CR-Nova/RCJ-soccer-CR_Nova/WhatsApp Image 2025-05-07 at 9.48.19 AM.jpeg

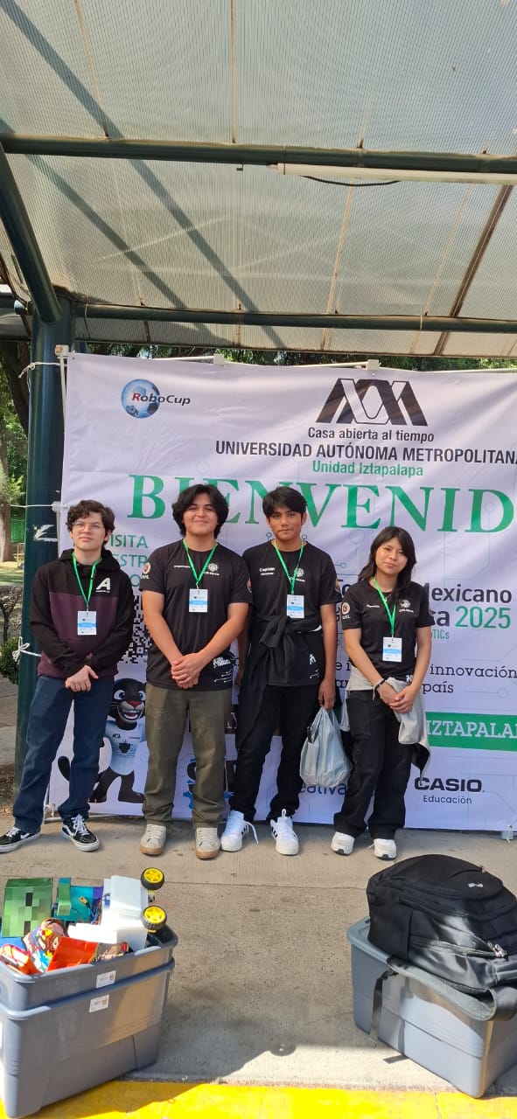
WhatsApp Image 2025-05-07 at 9.48.19 AM.jpeg
