CR-Nova/RCJ-soccer-CR_Nova/this desing was created.pdf

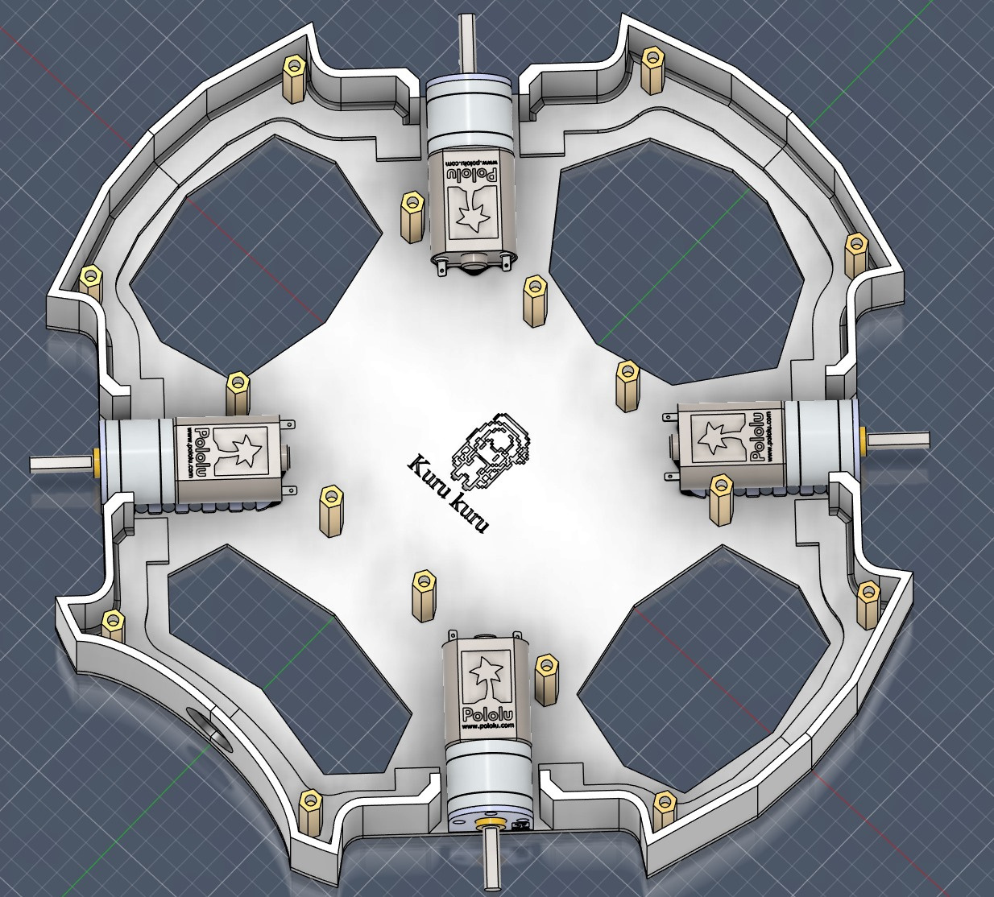
[picture p2: figure]

this design was created
so that the walls can be
easily uncoupled and
the robot is modular.

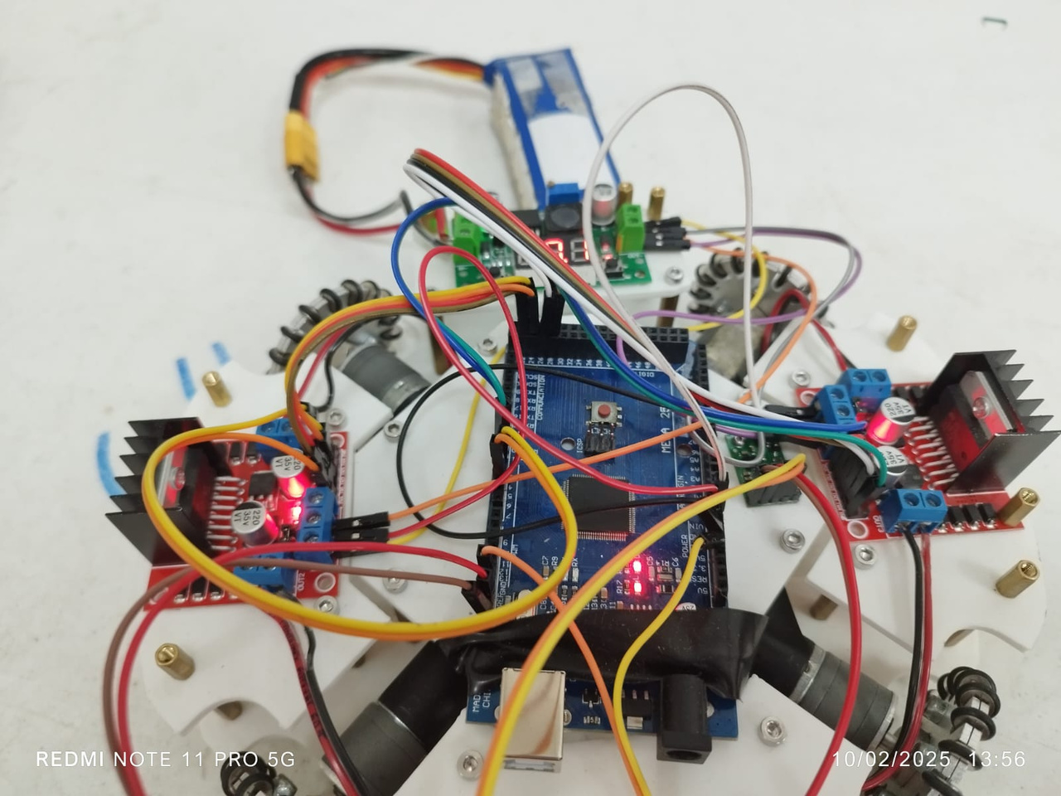
[picture p3: figure]

These were the
connections the robot
had before having the
pcb's.

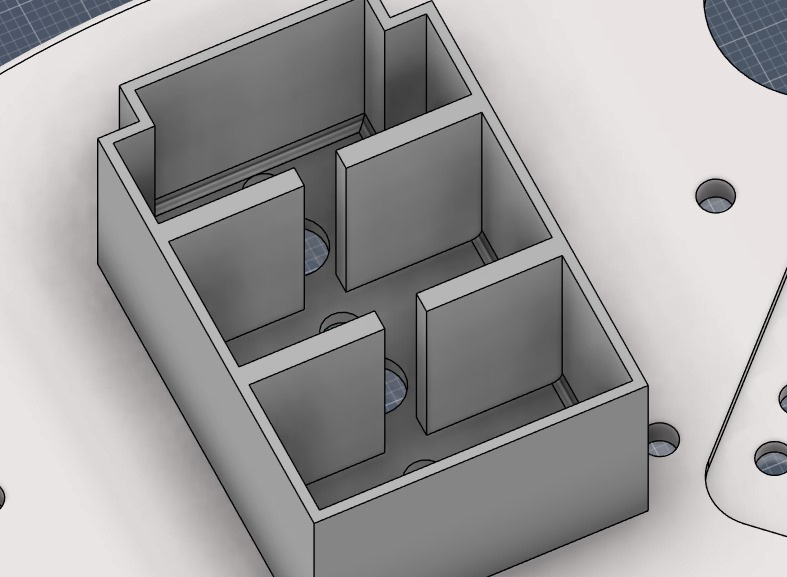
[picture p4: figure]

This was the first
design to use ldr
without a pcb.

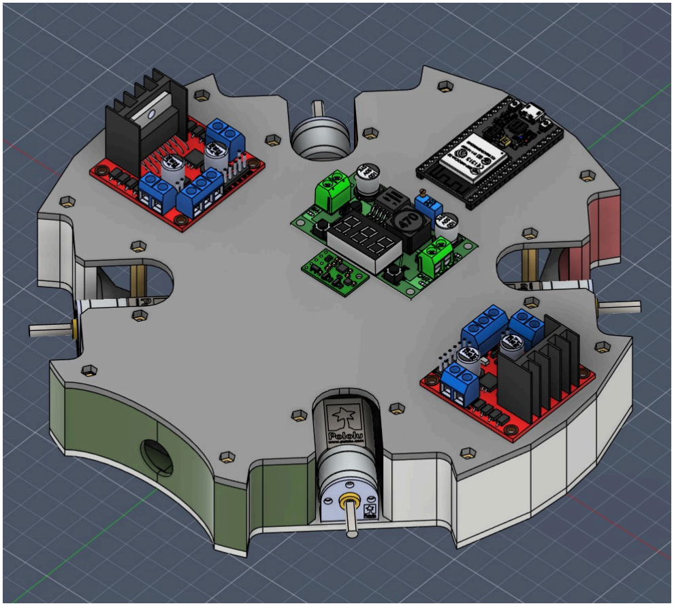
[picture p5: figure]

This is the design
contemplating that we
would use pcbs and we
had the idea of
implementing a kicker
but for economic
reasons we could not
implement it.

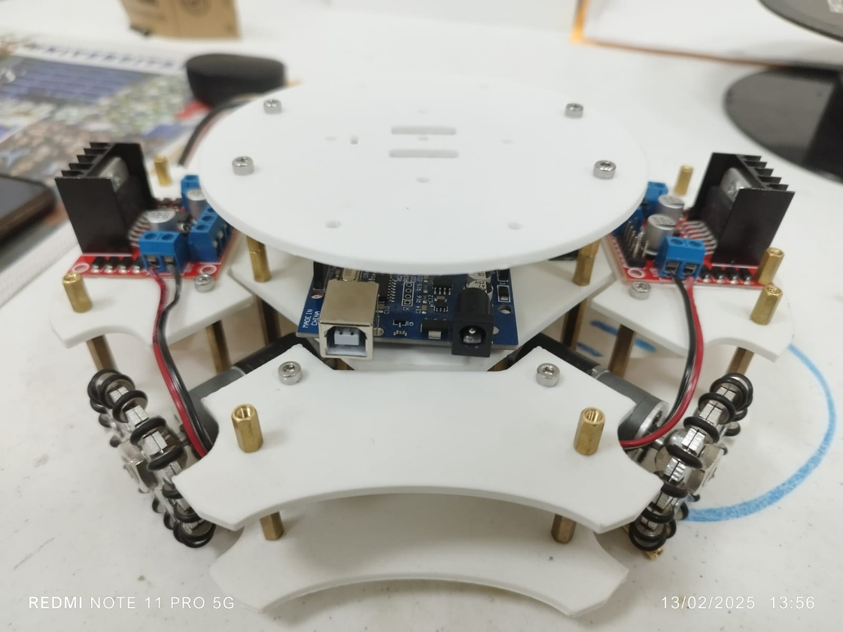
[picture p6: figure]

here the chassis had
already been printed
and the components
had been ordered

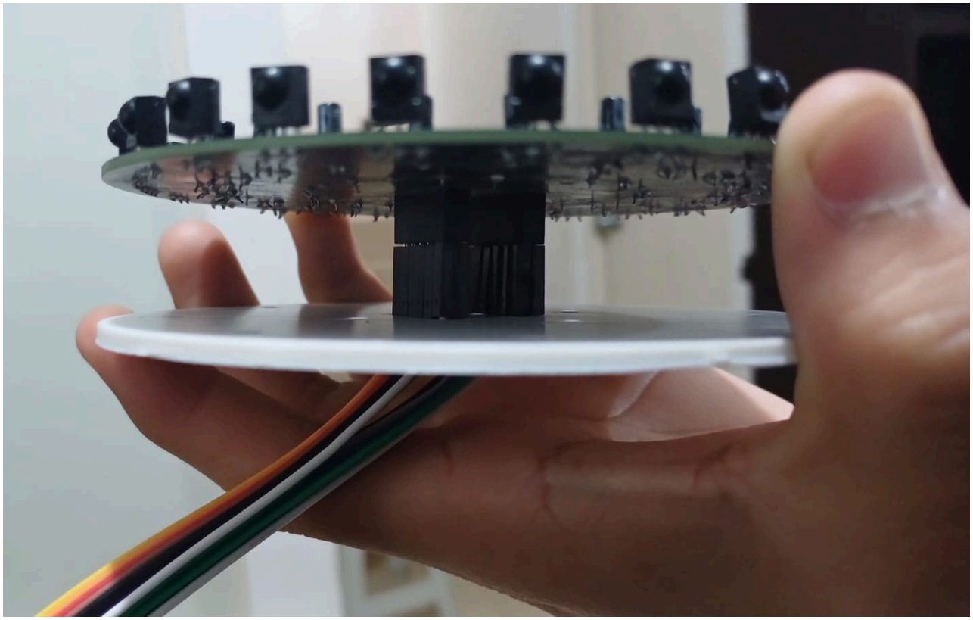
[picture p7: figure]

When we had the
plates ready to go we
started testing to see
how they would work.

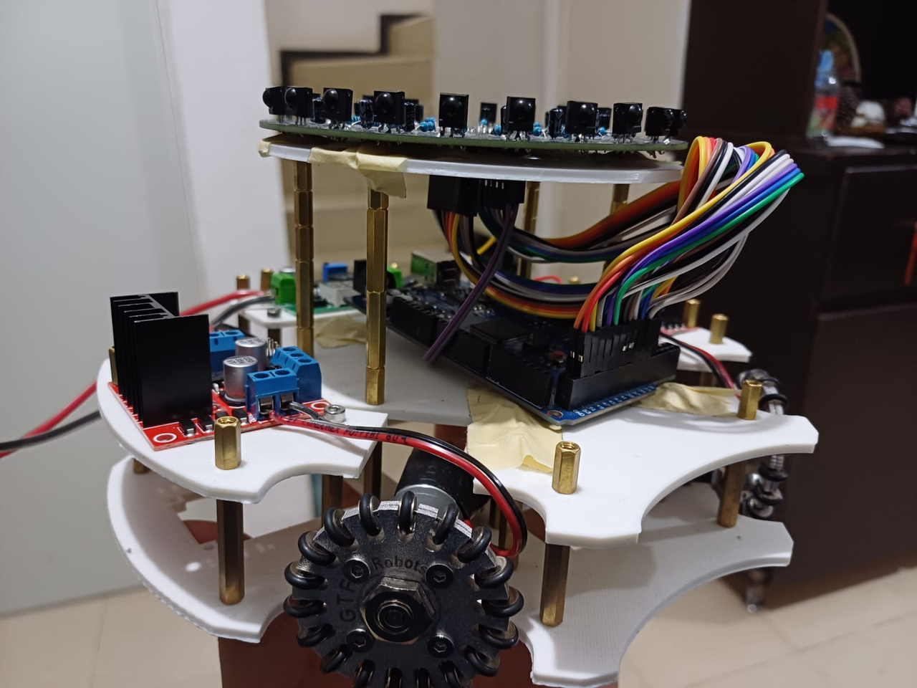
[picture p8: figure]

We arranged all the
parts of the robot and
the ir board was already
working.

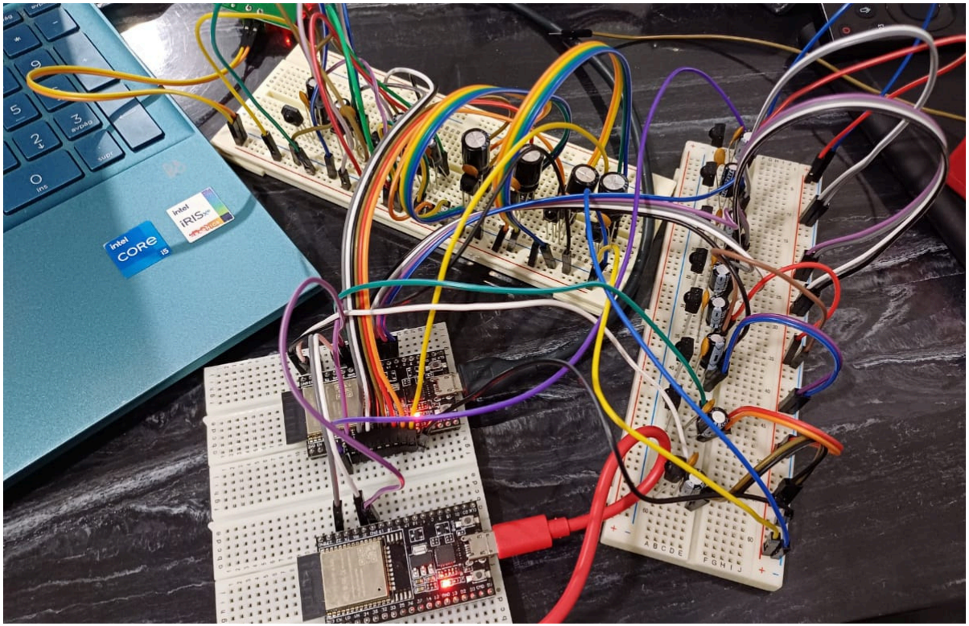
[picture p9: figure]

We made the schematic to test the operation of the second board, when it worked we tested the serial connection and ordered the board.

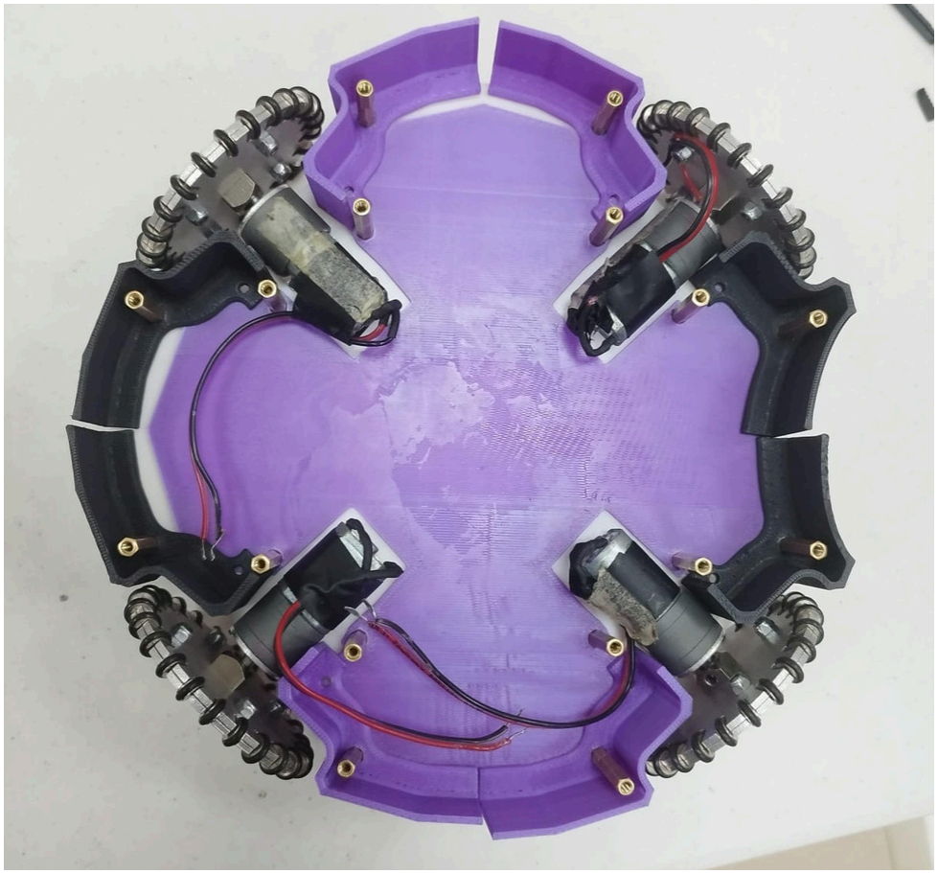
[picture p10: figure]

We made 3d printed
plates to test sizes
and shapes.

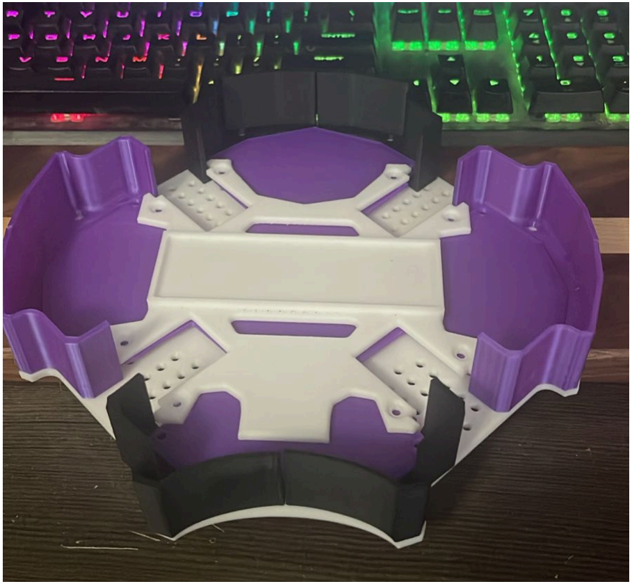
[picture p11: figure]

This is the final 3d
print design

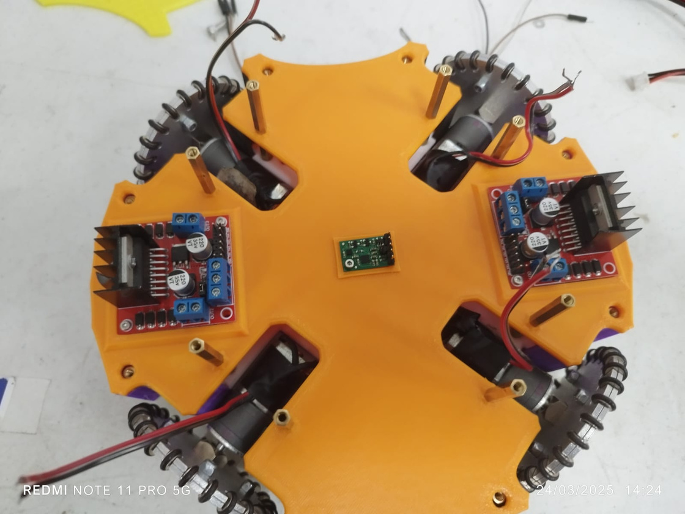
[picture p12: figure]

This is the second part
of the design with the
following components

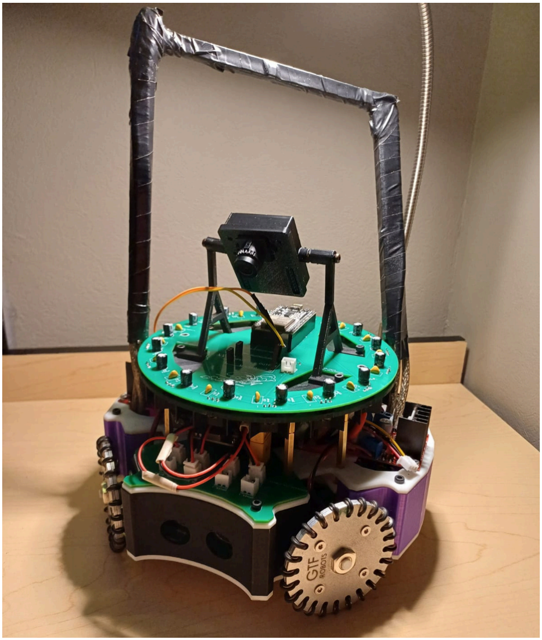
[picture p13: figure]

This is the final design
with the pcb and the open
mv
