CR-Nova/RCJ-soccer-CR_Nova/PCBs_PDFs/Schematic_PCB_CONTROLLER_2025-05-07.pdf

CLK 38 D0 37 D1 36 IO15 35 IO2 34 IO0 33 IO4 32 IO16 31 IO17 30 IO5 29 IO18 28 IO19 27 GND 26 IO21 25 RX 24 TX 23 IO22 22 IO23 21 GND 20

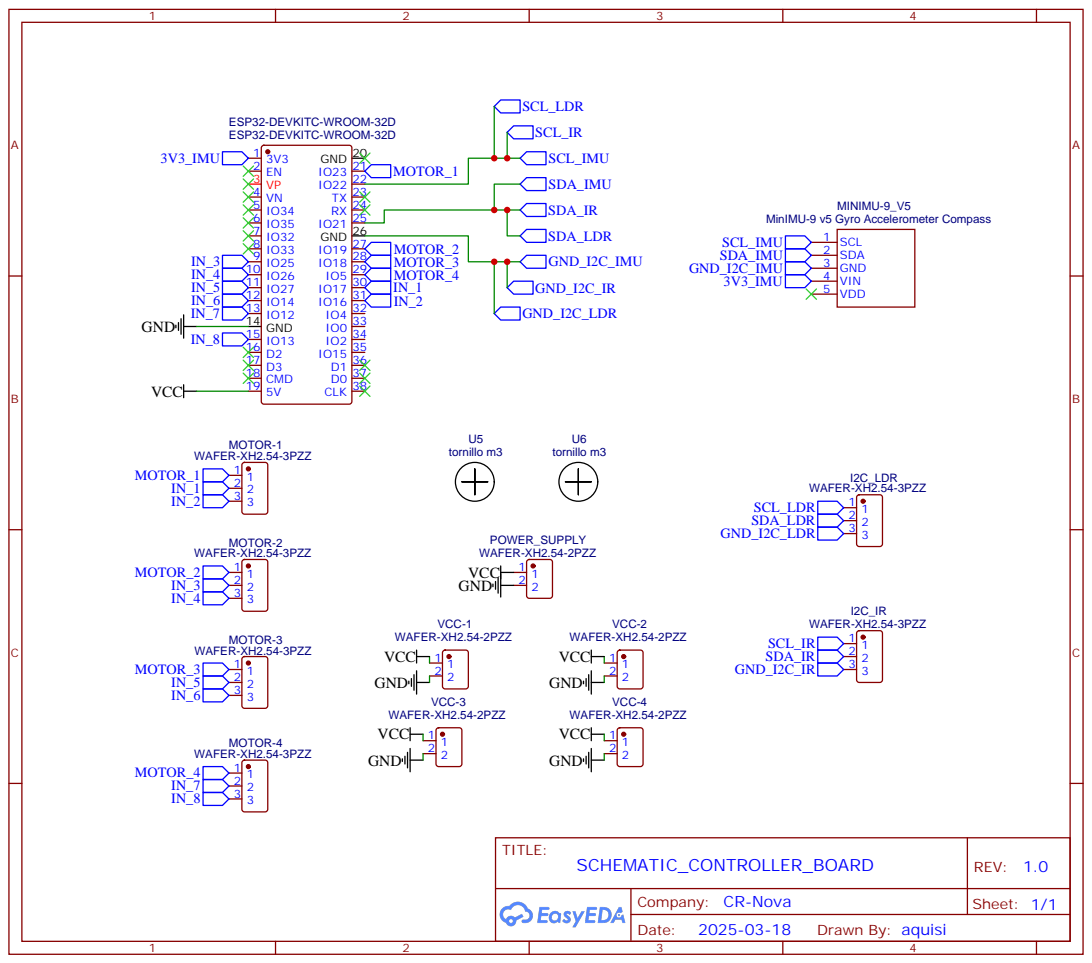
[picture p14: page 1]
