CR-Nova/RCJ-soccer-CR_Nova/PCBs_PDFs/Schematic_PCB_POWER_2025-05-07.pdf

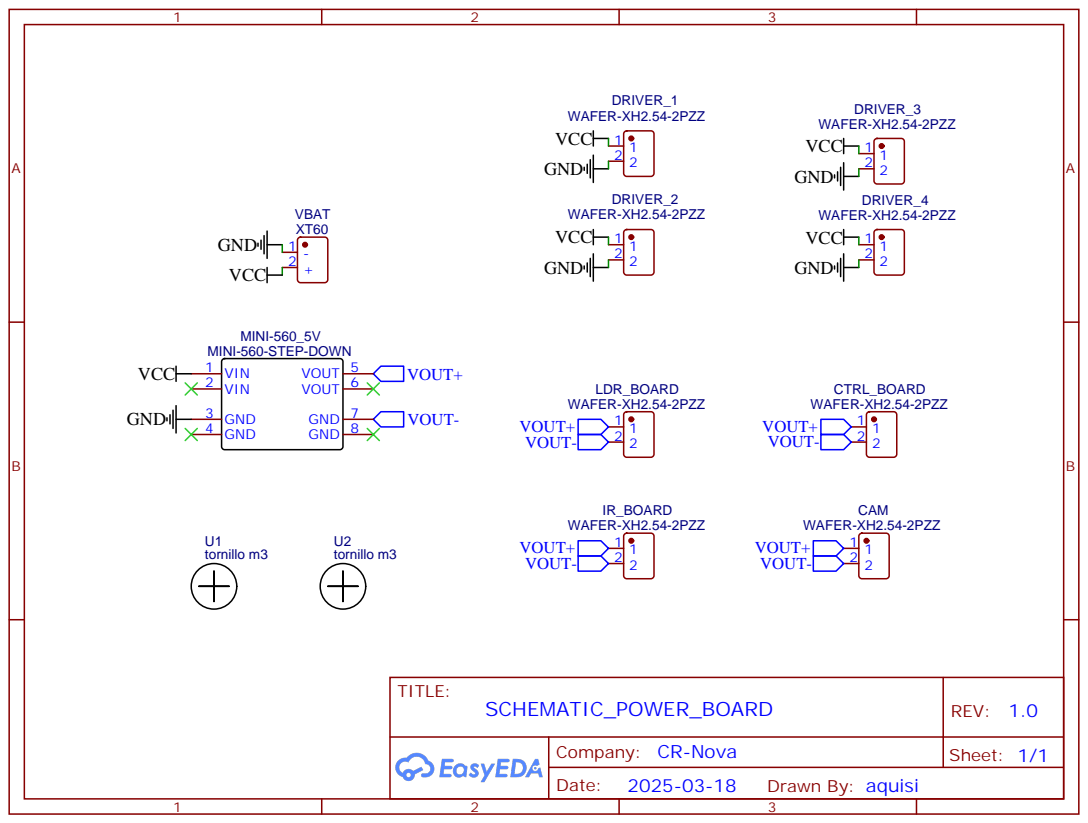
[picture p15: page 1]
