CR-Nova/RCJ-soccer-CR_Nova/PCBs_PDFs/PCB_CONTROLLER_2025-05-07.pdf

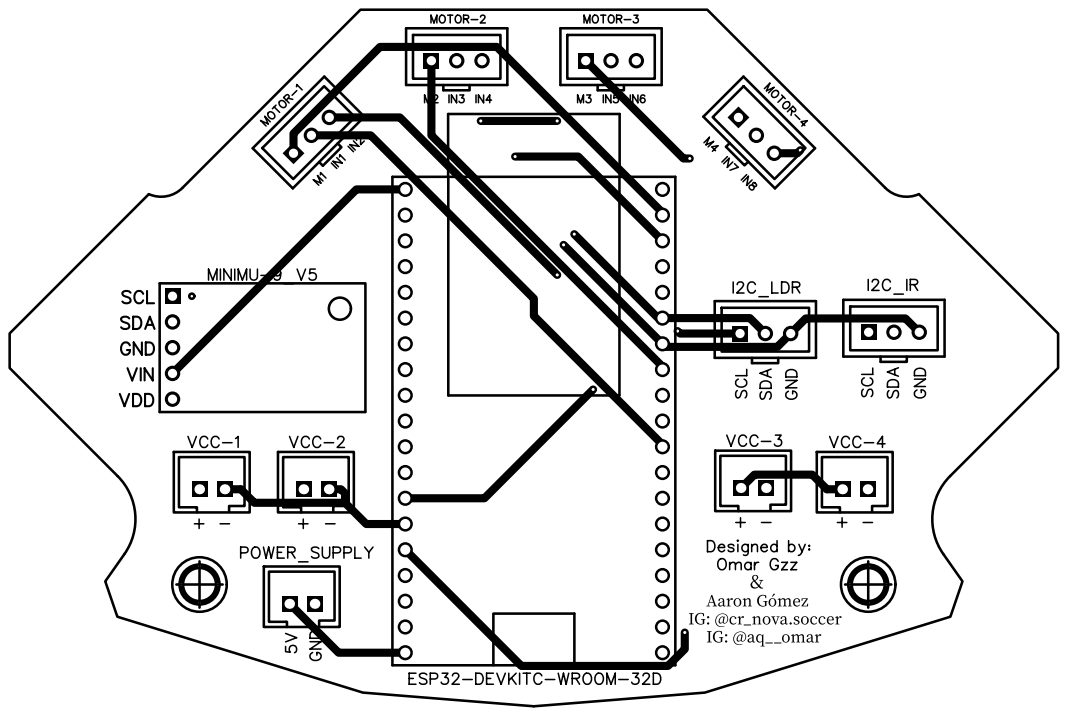
[picture p16: page 1]
