CR-Nova/RCJ-soccer-CR_Nova/PCBs_PDFs/PCB_IR_SENSORS_2025-05-07.pdf

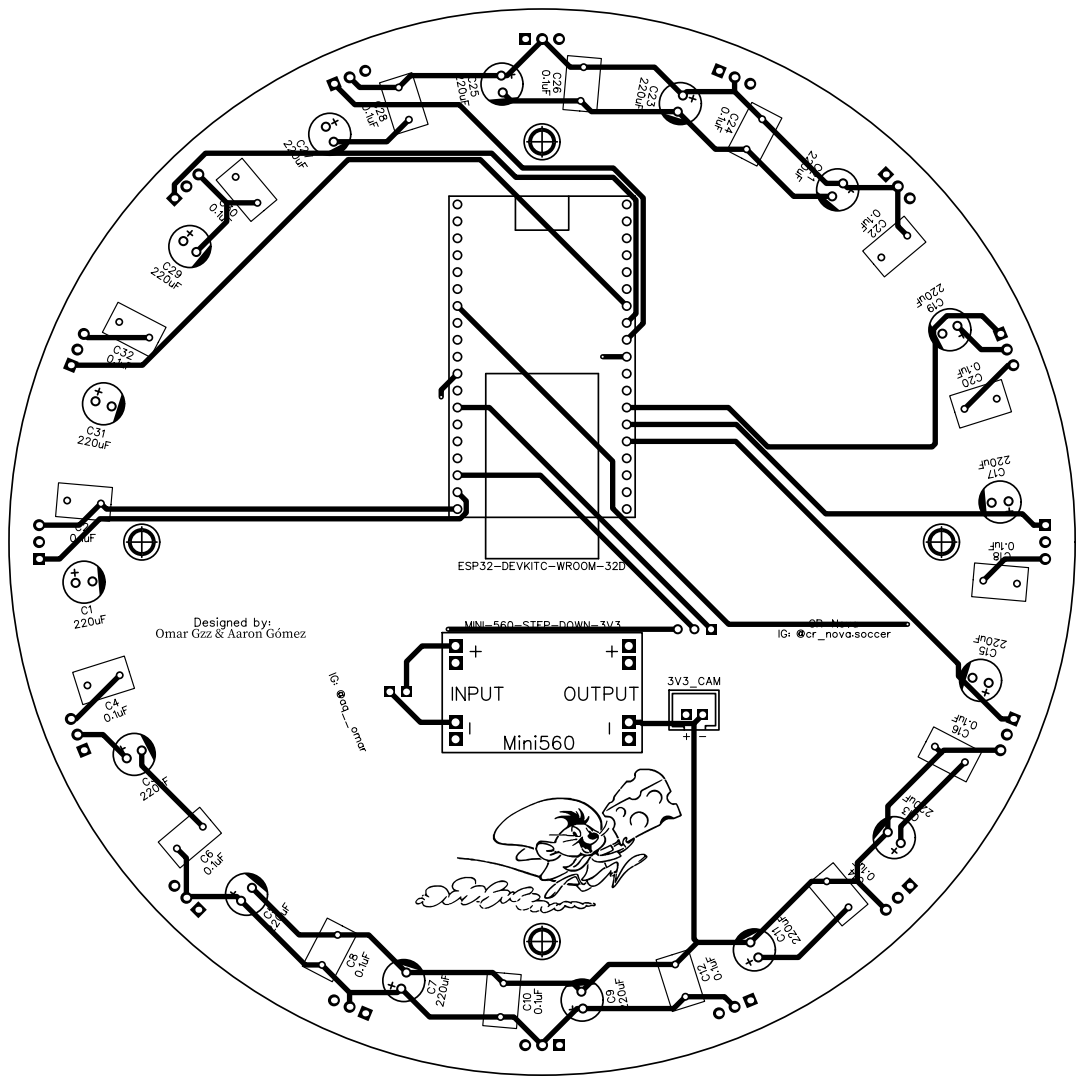
[picture p17: page 1]
