CR-Nova/RCJ-soccer-CR_Nova/PCBs_PDFs/PCB_LDRS_2025-05-07.pdf

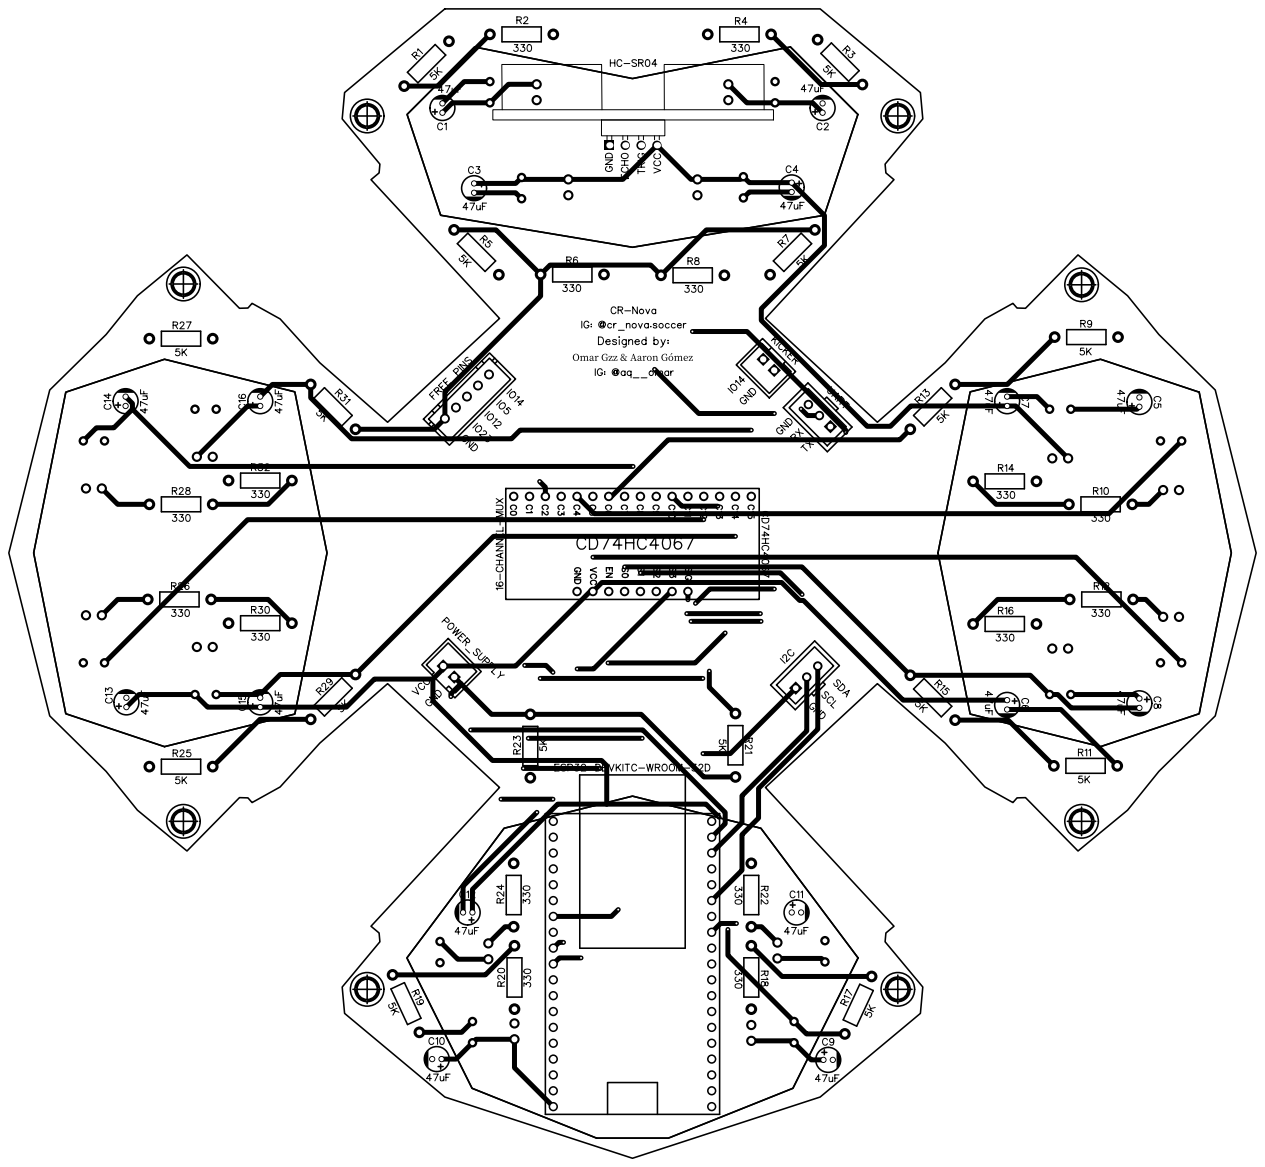
[picture p18: page 1]
