CR-Nova/RCJ-soccer-CR_Nova/PCBs_PDFs/PCB_POWER_2025-05-07.pdf

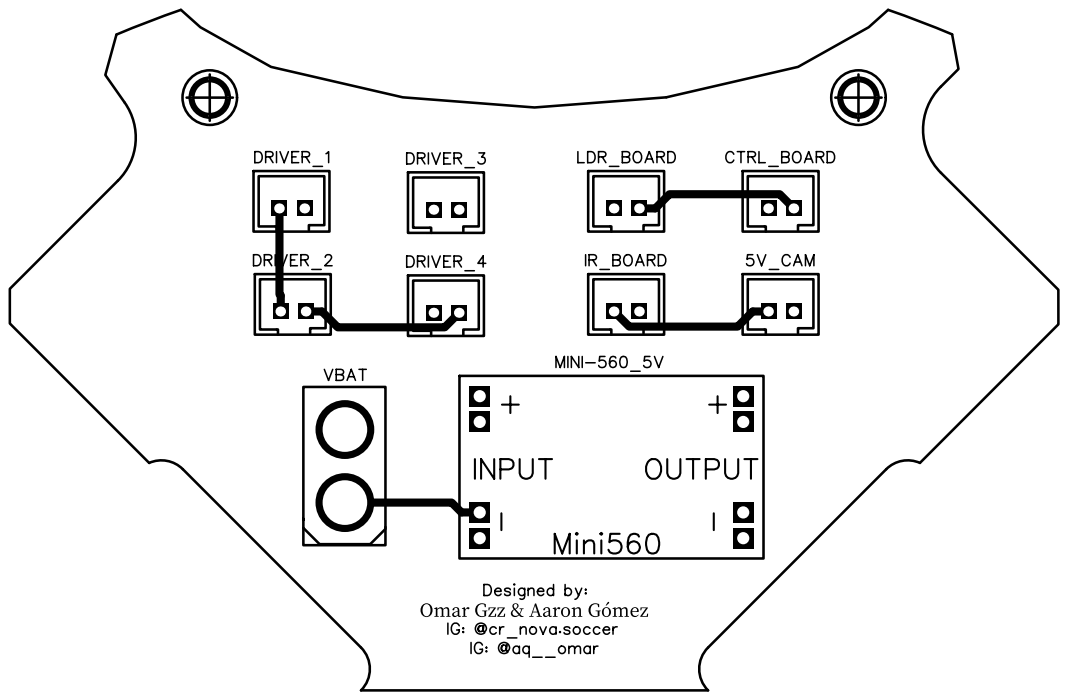
[picture p19: page 1]
